Synchrotron-SOLEIL/KiCad-Lib/README.md

KiCad-Lib
=========

This repository contains the components (schematic symbols and footprints) libraries used for miscellaneous projects developped by Synchrotron SOLEIL.

There are meant to be used with KiCad EDA (http://www.kicad-pcb.org).
They were created from scratch or modified from KiCad's libraries.

Projects includes:

- TimEX3 ; multipurpose FPGA (Xilinx Spartan 6) compact PCI board ; http://www.ohwr.org/projects/timex3/wiki
- TimIQ  ; sub picosecond laser / beam delay adjust ; https://ohwr.org/project/timiq
- Macbeth ; accelerator / beamlines synchronization system ; https://ohwr.org/project/macbeth

Please refer to KiCad libraries license terms (http://kicad-pcb.org/libraries/license).

Synchrotron SOLEIL's name and logo cannot be used without permission.

----------

https://www.synchrotron-soleil.fr/en
