Synchrotron-SOLEIL/KiCad-Lib/(commit log)

2012-03-26 First commit of KiCad librairies Not yet tested !
    On branch master
    new file: Lib/footprints/CPCI.brd
    new file: Lib/footprints/CPCI_connectors.mod
    new file: Lib/footprints/HE_connectors.mod
    new file: Lib/footprints/LED.mod
    new file: Lib/footprints/OSC_SMD.mod
    new file: Lib/footprints/PSU_connectors.mod
    new file: Lib/footprints/RCL_SMT.mod
    new file: Lib/footprints/SMA_connectors.mod
    new file: Lib/footprints/SO.mod
    new file: Lib/footprints/SOT23.mod
    new file: Lib/footprints/TO263.mod
    new file: Lib/footprints/TQFP.mod
    new file: Lib/footprints/TSOT23.mod
    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
2012-03-26 Added footprint to describtion (*.dcm) of some devices
    On branch development
    modified: Lib/symbols/connectors/HE_connectors.dcm
    modified: Lib/symbols/connectors/Lemo_connectors.dcm
    modified: Lib/symbols/connectors/PSU_connectors.dcm
    modified: Lib/symbols/connectors/SMA_connectors.dcm
    modified: Lib/symbols/connectors/cpci-connectors.dcm
    modified: Lib/symbols/discrets/transistors.dcm
    modified: Lib/symbols/optoelectronics/LED.dcm
    modified: Lib/symbols/passives/filters.dcm
    modified: Lib/symbols/psu/PSU.dcm
    modified: Lib/symbols/semiconductors/ECL.dcm
    modified: Lib/symbols/semiconductors/logiques.dcm
2012-04-04 Changed some wrong text size Changed the display fields of the "VAL**" to invidible
    modified: Lib/footprints/CPCI_connectors.mod
    modified: Lib/footprints/HE_connectors.mod
    modified: Lib/footprints/LED.mod
    modified: Lib/footprints/PSU_connectors.mod
    modified: Lib/footprints/RCL_SMT.mod
    modified: Lib/footprints/SMA_connectors.mod
    modified: Lib/footprints/SO.mod
    modified: Lib/footprints/SOT23.mod
    modified: Lib/footprints/TO263.mod
    modified: Lib/footprints/TQFP.mod
    modified: Lib/footprints/lemo_connectors.mod
    modified: Lib/footprints/passives.mod
    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
2012-04-04 Corrected a pin inversion on NFM55P (pin 2 and 3)
    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
2012-04-04 Changed the size of "VAL**" field to x=y=1.27mm
    modified: Lib/footprints/OSC_SMD.mod
    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
2012-04-05 Adjusted some shapes
    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
2012-04-06 Dicovered that KiCad don't update footprint lib from PCB :( Corrected lot of mismatches between lib and PCB
    modified: Lib/footprints/TSOT23.mod
    modified: Lib/footprints/p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
2012-04-06 Corrected some silk screen shapes
    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
2012-04-16 Added fixation holes librairy. Added logo of Soleil and Open Hardware
    new file: Lib/footprints/holes.mod
    new file: Lib/footprints/logo.mod
    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
2012-04-23 Added fixation librarie Corrected bad manufacturer ref in SMA connector
    modified: Lib/symbols/connectors/SMA_connectors.lib
    new file: Lib/symbols/mecanics/holes.dcm
    new file: Lib/symbols/mecanics/holes.lib
    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
2012-05-11 Added 2 fields : type of component (useful for the capacitors) price of component
    modified: Lib/symbols/FPGA/Xilinx-Spartan3.dcm
    modified: Lib/symbols/FPGA/Xilinx-Spartan3.lib
    modified: Lib/symbols/capacitors/capacitors_aluminium.dcm
    modified: Lib/symbols/capacitors/capacitors_aluminium.lib
    modified: Lib/symbols/capacitors/capacitors_ceramic.dcm
    modified: Lib/symbols/capacitors/capacitors_ceramic.lib
    modified: Lib/symbols/capacitors/capacitors_tantalum.dcm
    modified: Lib/symbols/capacitors/capacitors_tantalum.lib
    modified: Lib/symbols/connectors/HE_connectors.lib
    modified: Lib/symbol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
2012-07-06 Added schematic symbole of PLX PCI9030-AA60PI cPCI/local bus interface
    new file: Lib/symbols/interfaces/pci.dcm
    new file: Lib/symbols/interfaces/pci.lib
    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
2012-07-09 Renamed TQFP.mod library to QFP.mod Added PQFP176 to QFP.mod
    new file: Lib/footprints/QFP.mod
    deleted: Lib/footprints/TQFP.mod
    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
2012-07-13 Added BGA.mod lib with BGA256 footprint for Xilinx FTG256 SPARTAN6 FPGA
    new file: Lib/footprints/BGA.mod
    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
2012-07-16 Renamed Xilinx-Spartan3 schematic lib to Xilinx-Spartan Added Spartan6 XC6SLX9-2FTG256C schematic symbole
    new file: Lib/symbols/FPGA/Xilinx-Spartan.dcm
    new file: Lib/symbols/FPGA/Xilinx-Spartan.lib
    deleted: Lib/symbols/FPGA/Xilinx-Spartan3.dcm
    deleted: Lib/symbols/FPGA/Xilinx-Spartan3.lib
    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
2012-07-19 Added clock buffer CY2305CSXI-1H Added some resistors
    new file: Lib/symbols/interfaces/clock.dcm
    new file: Lib/symbols/interfaces/clock.lib
    new file: Lib/symbols/resistors/resistors_0603.dcm
    new file: Lib/symbols/resistors/resistors_0603.lib
    modified: Lib/symbols/resistors/resistors_0805.dcm
    modified: Lib/symbols/resistors/resistors_0805.lib
    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
2012-07-20 Added resistor network 10Kx4 ; 22Rx4 ; 10Rx4 Added footprint for resitor network 0612
    new file: Lib/symbols/resistors/resistors_network.dcm
    new file: Lib/symbols/resistors/resistors_network.lib
    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
2012-07-23 Added Xilinx XCF04SVOG20G Renamed SOLEIL-BGA256 to SOLEIL-BGA256_1mm
    modified: Lib/footprints/BGA.mod
    new file: Lib/footprints/TSSOP.mod
    modified: Lib/symbols/FPGA/Xilinx-Spartan.lib
    new file: Lib/symbols/memories/xcf.dcm
    new file: Lib/symbols/memories/xcf.lib
    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
2012-07-24 Added xilinx JTAG platform cable connector (MOLEX 87832-1420) Modified XCF04SVOG20 for easy wire to wire connction with the JTAG connector
    modified: Lib/symbols/memories/xcf.dcm
    modified: Lib/symbols/memories/xcf.lib
    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
2012-07-31 Added header connectors TSM102-01-S-DV (2x2 2.54mm) ; TSM111-01-S-DV (2x11 2.54mm) ; TSM123-01-S-DV (2x23 2.54mm)
    modified: README.md
    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
2012-08-09 Changed the name of the clock buffer library from clock.* to clock_buffers.* Added some C0G 0603 capacitors
    renamed: Lib/symbols/interfaces/clock.dcm -> Lib/symbols/interfaces/clock_buffers.dcm
    renamed: Lib/symbols/interfaces/clock.lib -> Lib/symbols/interfaces/clock_buffers.lib
    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
2012-08-10 Corrected typo in PLX PXI9030 schematic symbol
    modified: Lib/symbols/interfaces/pci.dcm
    modified: Lib/symbols/interfaces/pci.lib
    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
2012-08-20 Added 2.2K, 0805 resistor
    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
2012-08-24 Added header connector TSM-108-02-S-DV (2x8 2.54mm)
    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
2012-08-24 Added header connector TSM-108-04-S-DV (2x4 2.54mm)
    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
2012-08-30 Corrected cPCI pin D6 from input to output
    modified: Lib/symbols/connectors/cpci-connectors.lib
    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
2012-09-06 Corrected a slightly unaligned line in the shape of the PQFP176
    modified: Lib/footprints/QFP.mod
    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
2012-09-19 Corrected a slightly unaligned line in the shape of the TSSOP20 footprint
    modified: Lib/footprints/TSSOP.mod
    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
2012-09-21 Added 0603FA1.5-R fuse (1.5A ; 32V) in fuses.lib
    new file: Lib/symbols/passives/fuses.dcm
    new file: Lib/symbols/passives/fuses.lib
    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
2012-09-24 Added MC12CF 1.5 fuse (1.5A ; 63V ; 1206)
    modified: Lib/symbols/passives/fuses.dcm
    modified: Lib/symbols/passives/fuses.lib
    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
2012-09-26 Corrected a slightly unaligned line in the shape of the TYPEB capacitor footprint Added 20021121-00010C4LF header connector ; 2x5 points ; straight ; 1.27mm pitch ; 3mm height ; SMD
    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
2012-10-08 Added a new logo of Synchrotron SOLEIL to logo library
    modified: Lib/footprints/logo.mod
    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
2012-10-12 Added open hardware logo
    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
2012-10-16 Updated manufacturer ref of part 026481046
    modified: Lib/symbols/connectors/PSU_connectors.lib
    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
2012-10-17 Corrected the footprint of NFM55P
    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
2012-10-19 Corrected drill diameter of the optical pipe
    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
2015-06-19 Changed footprints to the new KiCad format. Updated symbols with new footprints. Added some new components.
    deleted: Lib/footprints/BGA.mod
    new file: Lib/footprints/BGA.pretty/SOLEIL-BGA256_1mm.kicad_mod
    deleted: Lib/footprints/CPCI_connectors.mod
    new file: Lib/footprints/CPCI_connectors.pretty/SOLEIL-CPCI-A.kicad_mod
    deleted: Lib/footprints/HE_connectors.mod
    new file: Lib/footprints/HE_connectors.pretty/SOLEIL-87832-1420.kicad_mod
    new file: Lib/footprints/HE_connectors.pretty/SOLEIL-HE-1.27-10.kicad_mod
    new file: Lib/footprints/HE_connectors.pretty/SOLEIL-HE-13-6.kicad_mod
    new file: Lib/footprints/HE_connectors.pretty/SOLEIL-TSM-102-DV.k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
2015-06-23 Added a 2.2nF capacitor and a 10uH inductor
    new file: Lib/symbols/inductors/inductors_1210.dcm
    new file: Lib/symbols/inductors/inductors_1210.lib
    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
2015-06-23 Corrected typo error in new lib name (RLC_SMT.pretty -> RCL_SMT.pretty)
    modified: inductors/inductors_1210.lib
    modified: passives/filters.dcm
    modified: passives/filters.lib
    modified: passives/fuses.lib
    modified: passives/passives.lib
    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
2015-07-07 Added HMC1097lp4 symbol and QFN24 footprint Corrected xcf symbol
    new file: Lib/footprints/QFP.pretty/SOLEIL-QFN24.kicad_mod
    new file: Lib/symbols/RF/modulator.dcm
    new file: Lib/symbols/RF/modulator.lib
    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
2015-07-20 Added LTC2758 DAC symbol
    new file: Lib/symbols/ADC-DAC/DAC.dcm
    new file: Lib/symbols/ADC-DAC/DAC.lib
    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
2015-07-21 Added LQFP48 ffotprint
    new file: Lib/footprints/QFP.pretty/SOLEIL-LQFP48.kicad_mod
    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
2015-07-22 Added voltages regulators
    modified: Lib/symbols/voltages/reference.dcm
    modified: Lib/symbols/voltages/reference.lib
    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
2015-07-23 Added MSOP8 footprint and some resistor
    new file: Lib/footprints/MSOP.pretty/SOLEIL-MSOP8.kicad_mod
    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
2015-07-27 Added some capacitors ; +15V and -15V symbols ; etc.
    modified: Lib/symbols/RF/modulator.lib
    modified: Lib/symbols/analogs/opa.lib
    modified: Lib/symbols/power.dcm
    modified: Lib/symbols/power.lib
    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
2015-07-27 Added 10uF ceramic capacitor
    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
2015-07-28 Added some resistore ; added LT1360CS8 OPA
    modified: Lib/symbols/analogs/opa.dcm
    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
2015-07-29 Added QWFN footprint
    new file: Lib/footprints/QFP.pretty/SOLEIL-WQFN36.kicad_mod
    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
2015-07-31 Added some 0603 resistors
    modified: Lib/symbols/resistors/resistors_0603.dcm
    modified: Lib/symbols/resistors/resistors_0603.lib
    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
2015-07-31 Corrected some typo error
    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
2015-08-03 Added some resistors and capacitors
    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
2015-08-04 Added some resistors, capacitors, a VCXO and a ferrite
    new file: Lib/footprints/OSC_SMD.pretty/SOLEIL-SMD9x14.kicad_mod
    modified: Lib/symbols/oscillators/oscillators.dcm
    modified: Lib/symbols/oscillators/oscillators.lib
    modified: Lib/symbols/passives/filters.lib
    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
2015-08-05 Typo correction
    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
2015-08-06 Added DQ1225 footprint
    new file: Lib/footprints/QFP.pretty/SOLEIL-DQ1225.kicad_mod
    modified: Lib/footprints/QFP.pretty/SOLEIL-WQFN36.kicad_mod
    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
2015-08-18 Added QCN-34+ RF splitter symbole and footprint
    new file: Lib/footprints/RCL_SMT.pretty/SOLEIL-FV1206-1.kicad_mod
    modified: Lib/symbols/RF/splitter.dcm
    modified: Lib/symbols/RF/splitter.lib
    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
2015-08-20 Corrected minor errors
    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
2015-08-21 Added SIM-73L+ RF mixer symbol and footprint
    new file: Lib/footprints/SO.pretty/SOLEIL-HV1195.kicad_mod
    new file: Lib/symbols/RF/mixer.dcm
    new file: Lib/symbols/RF/mixer.lib
    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
2015-08-24 Added a few resistors, capacitors and inductors
    new file: Lib/symbols/inductors/inductors_0603.dcm
    new file: Lib/symbols/inductors/inductors_0603.lib
    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
2015-09-15 Added GAT-5+ attenuator
    new file: Lib/footprints/passives.pretty/SOLEIL-FG873.kicad_mod
    new file: Lib/symbols/RF/attenuator.dcm
    new file: Lib/symbols/RF/attenuator.lib
    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
2015-09-18 Modified the name of RCL_SMT directory to RCL_SMD Added some resistors
    renamed: Lib/footprints/RCL_SMT.pretty/SOLEIL-0603.kicad_mod -> Lib/footprints/RCL_SMD.pretty/SOLEIL-0603.kicad_mod
    renamed: Lib/footprints/RCL_SMT.pretty/SOLEIL-0612.kicad_mod -> Lib/footprints/RCL_SMD.pretty/SOLEIL-0612.kicad_mod
    renamed: Lib/footprints/RCL_SMT.pretty/SOLEIL-0805.kicad_mod -> Lib/footprints/RCL_SMD.pretty/SOLEIL-0805.kicad_mod
    renamed: Lib/footprints/RCL_SMT.pretty/SOLEIL-1206.kicad_mod -> Lib/footprints/RCL_SMD.pretty/SOLEIL-1206.kicad_mod
    renamed: Lib/footprints/RCL_SMT.pretty/SOLEIL-1210.kicad_mod -> Lib/footprints/RCL_SMD.pretty/SOLEIL-1210.kicad_mod
    rena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
2015-09-18 Added 3d modelee to some resistors for tests purpose
    modified: Lib/footprints/RCL_SMD.pretty/SOLEIL-0603.kicad_mod
    modified: Lib/footprints/RCL_SMD.pretty/SOLEIL-0805.kicad_mod
    modified: Lib/footprints/RCL_SMD.pretty/SOLEIL-1206.kicad_mod
    modified: Lib/footprints/RCL_SMD.pretty/SOLEIL-2512.kicad_mod
    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
2015-09-28 Added some 0603 resitors
    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
2015-10-09 Added OPA2209AIDGKR OPA Added some 0603 resistors Added some 0603 capacitors
    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
2015-10-12 Swapped pin 2 and 3 in the OPA2209AIDGKR symbol
    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
2015-10-12 Added ADS8694IDBT ADC
    renamed: Lib/footprints/TSSOP.pretty/SOLEIL-TSSOP20.kicad_mod -> Lib/footprints/TSSOP.pretty/SOLEIL-TSSOP20-0.65.kicad_mod
    new file: Lib/footprints/TSSOP.pretty/SOLEIL-TSSOP38-0.5.kicad_mod
    new file: Lib/symbols/ADC-DAC/ADC.dcm
    new file: Lib/symbols/ADC-DAC/ADC.lib
    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
2015-10-13 Added 1.25V and 4.096V voltage reference
    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
2015-10-14 Chaged symbole shape ; added capacitors ; corrected typo in resistor lib
    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
2015-10-16 Added VQFN20 and WQFN24 footprint
    new file: Lib/footprints/QFP.pretty/SOLEIL-VQFN20.kicad_mod
    new file: Lib/footprints/QFP.pretty/SOLEIL-WQFN24.kicad_mod
    modified: Lib/symbols/psu/PSU.lib
    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
2015-10-19 Added TPS7A4700 LDO schematic symbol
    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
2015-10-19 Splitted ceramic capacitors symbols according to their package
    renamed: Lib/symbols/capacitors/capacitors_ceramic.dcm -> Lib/symbols/capacitors/capacitors_ceramic_0603.dcm
    renamed: Lib/symbols/capacitors/capacitors_ceramic.lib -> Lib/symbols/capacitors/capacitors_ceramic_0603.lib
    new file: Lib/symbols/capacitors/capacitors_ceramic_0805.dcm
    new file: Lib/symbols/capacitors/capacitors_ceramic_0805.lib
    new file: Lib/symbols/capacitors/capacitors_ceramic_1206.dcm
    new file: Lib/symbols/capacitors/capacitors_ceramic_1206.lib
    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
2015-10-19 Changed a pin name
    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
2015-12-14 Added 10 pF 0603 capacitor Corrected typo in LTC name
    modified: Lib/symbols/capacitors/capacitors_ceramic_0603.dcm
    modified: Lib/symbols/capacitors/capacitors_ceramic_0603.lib
    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
2016-02-01 Added SMA End Launch Jack for 0.047 inch PCB, 50 Ohm, Flat Tab Contact
    new file: Lib/footprints/SMA_connectors.pretty/SOLEIL-SMA-132430.kicad_mod
    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
2016-02-01 Added LP3966ES-3.3 3.3V LDO
    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
2016-02-02 Added SAMTEC QSH-040-01-F-D-DP-A footprint
    new file: Lib/footprints/HE_connectors.pretty/SOLEIL-QSH-040-01-F-D-DP-A.kicad_mod
    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
2016-02-03 Added QSH-040-01-F-D-DP-A symbol ; updated footprint
    modified: Lib/footprints/HE_connectors.pretty/SOLEIL-QSH-040-01-F-D-DP-A.kicad_mod
    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
2016-02-03 Add Spartan FPGA XC6SLX16-2FTG256C ; SN74LV4T125
    new file: Lib/footprints/TSSOP.pretty/SOLEIL-TSSOP14-0.65.kicad_mod
    modified: Lib/symbols/FPGA/Xilinx-Spartan.dcm
    modified: Lib/symbols/semiconductors/logic.dcm
    modified: Lib/symbols/semiconductors/logic.lib
    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
2016-02-08 Added EMI shield
    new file: Lib/footprints/passives.pretty/SOLEIL-BMI-S-204-F.kicad_mod
    new file: Lib/symbols/mecanics/RF_shields.dcm
    new file: Lib/symbols/mecanics/RF_shields.lib
    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
2016-02-08 Added QSPI EEPROM W25Q64FVSSIG
    modified: Lib/footprints/SO.pretty/SOLEIL-SOIC8NB.kicad_mod
    modified: Lib/symbols/memories/EEPROM.dcm
    modified: Lib/symbols/memories/EEPROM.lib
    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
2016-02-10 Added BeagleBone Black header
    new file: Lib/footprints/HE_connectors.pretty/SOLEIL-BeagleBoneBlack-P8.kicad_mod
    new file: Lib/footprints/HE_connectors.pretty/SOLEIL-BeagleBoneBlack-P9.kicad_mod
    new file: Lib/footprints/HE_connectors.pretty/SOLEIL-TSW-123-14-G-D.kicad_mod
    new file: Lib/symbols/microprocessors/BeagleBoneBlack_header.dcm
    new file: Lib/symbols/microprocessors/BeagleBoneBlack_header.lib
    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
2016-02-12 Added 2x13 2.54mm header footprint
    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
2016-02-18 Added 2 5V and 3V3 voltage symbols
    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
2016-02-19 Modification of SAMTEC diff connector
    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
2016-02-19 Added 10uF 16V 0805 X5R capacitor
    modified: Lib/symbols/capacitors/capacitors_ceramic_0805.dcm
    modified: Lib/symbols/capacitors/capacitors_ceramic_0805.lib
    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
2016-02-22 Added NFM41P filter
    new file: Lib/footprints/RCL_SMD.pretty/SOLEIL-NFM41P.kicad_mod
    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
2016-02-22 Added Molex Mini-fit 6 point connector
    new file: Lib/footprints/PSU_connectors.pretty/SOLEIL-39-30-1061.kicad_mod
    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
2016-02-24 Added some resistors
    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
2016-02-24 Corrected output type pin to input type
    modified: Lib/symbols/ADC-DAC/DAC.lib
    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
2016-02-25 Corrected ADS8694 missing pins
    modified: Lib/symbols/ADC-DAC/ADC.lib
    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
2016-02-29 Changed no connect pins of HMC705LP4E to power input as they are grounded in the demo board
    modified: Lib/symbols/RF/freq_div.lib
    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
2016-03-02 Corrected errors in 15V, -15V power symbols
    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
2016-03-04 Added Mini-Circuits MC1631 footprint
    new file: Lib/footprints/SO.pretty/SOLEIL-MC1631.kicad_mod
    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
2016-03-04 Corrected typo errors
    modified: Lib/symbols/inductors/inductors_0603.dcm
    modified: Lib/symbols/inductors/inductors_1210.dcm
    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
2016-03-04 Corrected some errors in symbols / footprints links
    modified: Lib/footprints/QFP.pretty/SOLEIL-WQFN24.kicad_mod
    modified: Lib/symbols/RF/mixer.lib
    modified: Lib/symbols/passives/passives.lib
    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
2016-04-28 Added and corrected footprints
    modified: Lib/footprints/BGA.pretty/SOLEIL-BGA256_1mm.kicad_mod
    modified: Lib/footprints/TSSOP.pretty/SOLEIL-TSSOP14-0.65.kicad_mod
    new file: Lib/footprints/passives.pretty/SOLEIL-1590Q.kicad_mod
    modified: Lib/symbols/mecanics/RF_shields.dcm
    modified: Lib/symbols/mecanics/RF_shields.lib
    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
2016-04-29 Added MAX IV logo Modified BOX pins footprint
    new file: Lib/footprints/logo.pretty/logo_maxvi_400.kicad_mod
    modified: Lib/footprints/passives.pretty/SOLEIL-1590Q.kicad_mod
    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
2016-05-06 Corrected missing Mask and Paste zone on bottom pins
    modified: Lib/footprints/SMA_connectors.pretty/SOLEIL-SMA-132430.kicad_mod
    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
2016-05-11 Corrected some supplier ref.
    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
2016-06-01 Added RS485 components
    new file: Lib/footprints/PSU_connectors.pretty/SOLEIL-1725669.kicad_mod
    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
2016-06-01 Changed text size to 1 mm and thickness to 0.15 mm
    modified: Lib/footprints/CPCI_connectors.pretty/SOLEIL-CPCI-A.kicad_mod
    modified: Lib/footprints/HE_connectors.pretty/SOLEIL-87832-1420.kicad_mod
    modified: Lib/footprints/HE_connectors.pretty/SOLEIL-BeagleBoneBlack-P8.kicad_mod
    modified: Lib/footprints/HE_connectors.pretty/SOLEIL-BeagleBoneBlack-P9.kicad_mod
    modified: Lib/footprints/HE_connectors.pretty/SOLEIL-HE-1.27-10.kicad_mod
    modified: Lib/footprints/HE_connectors.pretty/SOLEIL-HE-13-6.kicad_mod
    modified: Lib/footprints/HE_connectors.pretty/SOLEIL-QSH-040-01-F-D-DP-A.kicad_mod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
2016-06-02 Added 68 µF tantalum capacitor
    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
2016-06-03 Added SI500 100MHz LVEPCL 3V3 oscillator symbol and footprint
    new file: Lib/footprints/OSC_SMD.pretty/SOLEIL-SMD5x7.kicad_mod
    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
2016-06-03 Added 130R and 82R 0603 resitors
    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
2016-06-07 Added Ethernet PHY LAN8810
    new file: Lib/footprints/QFP.pretty/SOLEIL-WQFN72.kicad_mod
    new file: Lib/symbols/interfaces/ethernet.dcm
    new file: Lib/symbols/interfaces/ethernet.lib
    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
2016-06-08 Added RJ45 connector
    new file: Lib/footprints/RJ45_connectors.pretty/SOLEIL-RJ45-HFJ11-1G01E-L12RL.kicad_mod
    new file: Lib/symbols/connectors/RJ45_connectors.dcm
    new file: Lib/symbols/connectors/RJ45_connectors.lib
    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
2016-06-08 Added 25 MHz crystal
    new file: Lib/footprints/OSC_SMD.pretty/SOLEIL-HC49S.kicad_mod
    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
2016-06-08 Added 2.5V 3A LDO
    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
2016-06-09 Added 8K06 resistor
    modified: Lib/symbols/interfaces/ethernet.lib
    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
2016-06-21 Corrected inversion in P8/P9 BBB connectors
    renamed: Lib/footprints/HE_connectors.pretty/SOLEIL-BeagleBoneBlack-P9.kicad_mod -> Lib/footprints/HE_connectors.pretty/SOLEIL-BeagleBoneBlack-P8.kicad_mod
    renamed: Lib/footprints/HE_connectors.pretty/SOLEIL-BeagleBoneBlack-P8.kicad_mod -> Lib/footprints/HE_connectors.pretty/SOLEIL-BeagleBoneBlack-P9.kicad_mod
    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
2016-06-22 Added 25MHz crystal in 5x3.2mm case SMD
    new file: Lib/footprints/OSC_SMD.pretty/SOLEIL-SMD5x3_2.kicad_mod
    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
2016-07-01 Corrected some pin spaces due to KiCad version conversion
    modified: Lib/footprints/TSOT23.pretty/SOLEIL-TSOT23-8.kicad_mod
    modified: Lib/footprints/TSSOP.pretty/SOLEIL-TSSOP20-0.65.kicad_mod
    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
2016-07-08 Removed mask clerance from BGA 256 footprint
    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
2016-09-20 Added 3.1 mm and 3.0 mm holes
    modified: Lib/footprints/holes.pretty/SOLEIL-D_2mm8.kicad_mod
    new file: Lib/footprints/holes.pretty/SOLEIL-D_3mm0.kicad_mod
    new file: Lib/footprints/holes.pretty/SOLEIL-D_3mm1.kicad_mod
    modified: Lib/symbols/mecanics/holes.dcm
    modified: Lib/symbols/mecanics/holes.lib
    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
2017-04-27 Added some 0603 resistors and capacitors
    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
2018-07-24 Added some 3d shapes Corrected uppercase / lowercase error for KiCad V5
    On branch KiCad_V5
    modified: Lib/footprints/RCL_SMD.pretty/SOLEIL-1210.kicad_mod
    modified: Lib/footprints/RCL_S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
2018-07-25 Adding 3d models
    modified: Lib/footprints/LED.pretty/SOLEIL-KP-3216.kicad_mod
    modified: Lib/footprints/LED.pretty/SOLEIL-M67K.kicad_mod
    modified: Lib/footprints/MSOP.pretty/SOLEIL-MSOP8.kicad_mod
    modified: Lib/footprints/OSC_SMD.pretty/SOLEIL-FXO-HC73.kicad_mod
    modified: Lib/footprints/RCL_SMD.pretty/SOLEIL-0612.kicad_mod
    modified: Lib/footprints/RCL_SMD.pretty/SOLEIL-PC-A.kicad_mod
    modified: Lib/footprints/RCL_SMD.pretty/SOLEIL-PC-B.kicad_mod
    modified: Lib/footprints/RCL_SMD.pretty/SOLEIL-TYPEB.kicad_mod
    modified: Lib/footprints/RCL_SMD.pretty/SOLEIL-TYPEE.kicad_mod
    new file: Lib/packages3d_extra/LED_SMD.3dshapes/Osram_M67K_L2.3mm_W1.3mm_H1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
2018-07-26 Added some 3D shapes:
    new file: Lib/packages3d_extra/Connector_Samtec.3dshapes/Samtec_QSH_040_01_F_D_DP_A.step
    new file: Lib/packages3d_extra/Connector_Samtec.3dshapes/Samtec_QSH_040_01_F_D_DP_A.wrl
    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
2018-07-27 Reorganised 3D folders ; added some models
    modified: Lib/footprints/RJ45_connectors.pretty/SOLEIL-RJ45-HFJ11-1G01E-L12RL.kicad_mod
    modi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
2018-07-27 Modified README.md
    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
2018-07-27 added 3D models
    modified: Lib/footprints/OSC_SMD.pretty/SOLEIL-SMD5x7.kicad_mod
    modified: Lib/footprints/PSU_connectors.pretty/SOLEIL-1725669.kicad_mod
    modified: Lib/footprints/PSU_connectors.pretty/SOLEIL-39-30-1061.kicad_mod
    modified: Lib/footprints/QFP.pretty/SOLEIL-LQFP48.kicad_mod
    modified: Lib/footprints/QFP.pretty/SOLEIL-PQFP176.kicad_mod
    modified: Lib/footprints/QFP.pretty/SOLEIL-QFN24.kicad_mod
    modified: Lib/footprints/QFP.pretty/SOLEIL-TQFP144.kicad_mod
    modified: Lib/footprints/QFP.pretty/SOLEIL-VQFN20.kicad_mod
    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
2018-07-30 dded 3D models
    modified: Lib/footprints/QFP.pretty/SOLEIL-DQ1225.kicad_mod
    modified: Lib/footprints/SMA_connectors.pretty/SOLEIL-SMA-132134.kicad_mod
    new file: Lib/packages3d/Connector_Coaxial.3dshapes/SMA_Molex_733910071_Jack_Vertical.step
    new file: Lib/packages3d/Connector_Coaxial.3dshapes/SMA_Molex_733910071_Jack_Vertical.wrl
    new file: Lib/packages3d/Connector_PinHeader_1.27mm.3dshapes/PinHeader_2x05_P1.27mm_Vertical_SMD.step
    new file: Lib/packages3d/Connector_PinHeader_1.27mm.3dshapes/PinHeader_2x05_P1.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
2018-08-03 Corrected 3D models
    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
2018-08-06 Added compact PCI type A 3D model
    new file: Lib/packages3d/Connector_Erni.3dshapes/Erni_064176_cPCI_TypeA.step
    new file: Lib/packages3d/Connector_Erni.3dshapes/Erni_064176_cPCI_TypeA.wrl
    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
2018-08-06 Added 3D models
    modified: Lib/footprints/HE_connectors.pretty/SOLEIL-TSM-102-DV.kicad_mod
    modified: Lib/footprints/HE_connectors.pretty/SOLEIL-TSM-104-DV.kicad_mod
    modified: Lib/footprints/HE_connectors.pretty/SOLEIL-TSM-108-DV.kicad_mod
    modified: Lib/footprints/HE_connectors.pretty/SOLEIL-TSM-111-DV.kicad_mod
    modified: Lib/footprints/HE_connectors.pretty/SOLEIL-TSM-123-DV.kicad_mod
    modified: Lib/footprints/HE_connectors.pretty/SOLEIL-TSW-123-14-G-D.kicad_mod
    new file: Lib/packages3d/Connector_Samtec.3dshapes/Samtec_TSM_102_02_S_DV_2x2_P2.54mm_Vetical.step
    new file: Lib/packages3d/Connector_Samtec.3dshapes/Samtec_TSM_102_02_S_DV_2x2_P2.54mm_Vetical.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
2018-08-10 Added 3 D shapes
    new file: Lib/packages3d/Package_QFP.3dshapes/QFN-12-1EP_3x3mm_Pitch0.5mm.step
    new file: Lib/packages3d/Package_QFP.3dshapes/QFN-12-1EP_3x3mm_Pitch0.5mm.wrl
    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
2018-08-10 Added Mini-circuit 3D shape FG873
    modified: Lib/footprints/passives.pretty/SOLEIL-FG873.kicad_mod
    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
2018-08-21 Added 3D Model for Mini-Circuit GAT-5+ attenuator (FG873 package)
    new file: Lib/packages3d/Package_DFN_QFN.3dshapes/Mini-Circuits_FG873-4_3x3mm.step
    new file: Lib/packages3d/Package_DFN_QFN.3dshapes/Mini-Circuits_FG873-4_3x3mm.wrl
    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
2021-02-15 Update the lib for Kicad v6
    Updating the library for the v6 of Kicad.
    So far:
    * resitors
    * resistor networks
    * ADC
    * DAC
    On branch kicad_v6
    deleted: Lib/symbols/ADC-DAC/ADC.dcm
    new file: Lib/symbols/ADC-DAC/ADC.kicad_sym
    deleted: Lib/symbols/ADC-DAC/ADC.lib
    deleted: Lib/symbols/ADC-DAC/DAC.dcm
    new file: Lib/symbols/ADC-DAC/DAC.kicad_sym
    deleted: Lib/symbols/ADC-DAC/DAC.lib
    deleted: Lib/symbols/resistors/resistors_0603.dcm
    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
2021-02-16 Upgrade library to Kicad v6
    Upgraded the libray for Kicad v6:
    * Ceramic capacitors
    * Aluminim capacitors
    * Tantalum capacitors
    deleted: Lib/symbols/capacitors/capacitors_aluminium.dcm
    new file: Lib/symbols/capacitors/capacitors_aluminium.kicad_sym
    deleted: Lib/symbols/capacitors/capacitors_aluminium.lib
    deleted: Lib/symbols/capacitors/capacitors_ceramic_0603.dcm
    new file: Lib/symbols/capacitors/capacitors_ceramic_0603.kicad_sym
    deleted: Lib/symbols/capacitors/capacitors_ceramic_0603.lib
    deleted: Lib/symbols/capacitors/capacitors_ceramic_0805.dcm
    new file: Lib/symbols/capacitors/capacitors_ceramic_0805.kicad_sym
    deleted: Lib/symbols/capa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
2021-02-16 Upgrading library for Kicad v6
    Changed the folders names to match Kicad name
    Upgraded library:
    * Analog AOP
    * Transistors
    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
2021-02-16 Upgrade to Kicad v6
    Upgrade of library to Kicad v6:
    * cPCI connector
    * Mini-circuit AOP
    * Inductors
    new file: library/connectors/CPCI_connectors.kicad_sym
    deleted: library/inductors/inductors_0603.dcm
    new file: library/inductors/inductors_0603.kicad_sym
    deleted: library/inductors/inductors_0603.lib
    deleted: library/inductors/inductors_1210.dcm
    deleted: library/inductors/inductors_1210.lib
    deleted: modules/CPCI_connectors.pretty/SOLEIL-CPCI-A.kicad_mod
    new file: modules/Connector_Erni.pretty/Erni_ERmet_Female_Type_A-354142.kicad_mod
    modified: modules/RF_Mini-Circuits.pretty/Mini-Circuits_MC1631.kicad_mod
    renamed: packages3d/Connector_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
2021-02-17 Added Block transformer
    Added Block VB 1,0/1/6 transformer to the library
    Modified absolute links to relative links
    deleted: Lib/library/connectors/CPCI_connectors.dcm
    deleted: Lib/library/connectors/CPCI_connectors.lib
    new file: Lib/library/psu/Transformer.kicad_sym
    modified: Lib/modules/Connector_Erni.pretty/Erni_ERmet_Female_Type_A-354142.kicad_mod
    new file: Lib/modules/Transformer.pretty/Block_VB_1_0_1_6-28x33.kicad_mod
    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
2021-02-18 Upgrading to Kicad v6 and adding some components
    Added 820R (1% and 0.1%)
    Added LTC6702 comparator
    Added LTC6752 comparator (copy from Kicad lib)
    Added MB6S diode bridge (copy from Kicad lib)
    renamed: Lib/library/analogs/opa.kicad_sym -> Lib/library/analogs/Amplifier.kicad_sym
    new file: Lib/library/analogs/Comparator.kicad_sym
    new file: Lib/library/discretes/diode_bridge.kicad_sym
    modified: Lib/library/resistors/resistors_0603.kicad_sym
    modified: Lib/library/resistors/resistors_0805.kicad_sym
    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
2021-02-19 Upgrade to Kicad v6
    Upgraded the voltage reference
    Added LTC6655-3.3 voltage reference
    deleted: Lib/library/voltages/reference.dcm
    new file: Lib/library/voltages/reference.kicad_sym
    deleted: Lib/library/voltages/reference.lib
    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
2021-02-19 Upgrade of library to Kicad v6
    Upgraded:
    * PSU LDO
    * Voltage monitor
    new file: Lib/library/psu/LDO.kicad_sym
    deleted: Lib/library/psu/PSU.dcm
    deleted: Lib/library/psu/PSU.lib
    new file: Lib/library/voltages/Voltage_monitor.kicad_sym
    renamed: Lib/library/voltages/reference.kicad_sym -> Lib/library/voltages/Voltage_reference.kicad_sym
    renamed: Lib/packages3d/Package_DFN_QFN.3dshapes/VQFN-20_5x5mm_P0.65mm.step -> Lib/packages3d/Package_DFN_QFN.3dshapes/Texas_S-PVQFN-N20_EP3.15x3.15mm.step
    renamed: Lib/packages3d/Package_DFN_QFN.3dshapes/VQFN-20_5x5mm_P0.65mm.wrl -> Lib/packages3d/Package_DFN_QFN.3dshapes/Texas_S-PVQFN-N20_EP3.15x3.15mm.wrl
    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
2021-02-19 Removed visible datasheet links
    Removed some visible datasheet links in components property to avoid
    show them in shematocs
    modified: Lib/library/psu/LDO.kicad_sym
    modified: Lib/library/voltages/Voltage_monitor.kicad_sym
    modified: Lib/library/voltages/Voltage_reference.kicad_sym
    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
2021-02-22 Added Phonix Contact MKDS 1x2 terminal connector
    new file: Lib/library/connectors/Terminal_connectors.kicad_sym
    new file: Lib/modules/Connector_Phoenix.pretty/Phoenix_MKDS_1x02_P5mm_Vertical.kicad_mod
    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
2021-02-23 Updating library to Kicad v6
    Updated the PinHeader Connectors HE to Kicad v6
    deleted: Lib/library/connectors/HE_connectors.dcm
    new file: Lib/library/connectors/HE_connectors.kicad_sym
    deleted: Lib/library/connectors/HE_connectors.lib
    modified: Lib/modules/HE_connectors.pretty/SOLEIL-87832-1420.kicad_mod
    modified: Lib/modules/HE_connectors.pretty/SOLEIL-BeagleBoneBlack-P8.kicad_mod
    modified: Lib/modules/HE_connectors.pretty/SOLEIL-BeagleBoneBlack-P9.kicad_mod
    modified: Lib/modules/HE_connectors.pretty/SOLEIL-HE-1.27-10.kicad_mod
    modified: Lib/modules/HE_connectors.pretty/SOLEIL-HE-13-6.kicad_mod
    modified: Lib/modules/HE_connectors.pretty/SOLE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
2021-02-25 Added Cora Z7 footprint
    Added the Digilent's Zynq SBC Cora Z7 footprint
    renamed: Lib/library/microprocessors/BeagleBoneBlack_header.dcm -> Lib/library/SBC/BeagleBoneBlack_header.dcm
    renamed: Lib/library/microprocessors/BeagleBoneBlack_header.lib -> Lib/library/SBC/BeagleBoneBlack_header.lib
    new file: Lib/modules/SBC.pretty/Cora_Z7.kicad_mod
    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
2021-02-25 Added Cora Z7 schematic symbol
    Added the Cora Z7 symbol to the library
    new file: Lib/library/SBC/SBC.kicad_sym
    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
2021-02-26 Updated the logic lib to Kicad v6
    Updated the logic library to Kicad v6
    Corrected en error in SBC shematic library
    modified: Lib/library/SBC/SBC.kicad_sym
    deleted: Lib/library/semiconductors/logic.dcm
    new file: Lib/library/semiconductors/logic.kicad_sym
    deleted: Lib/library/semiconductors/logic.lib
    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
2021-02-26 Added a SMA connector to the library
    new file: Lib/library/connectors/SMA_connectors.kicad_sym
    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
2021-03-01 Added some capacitors and resitors
    modified: Lib/library/capacitors/capacitors_ceramic_0805.kicad_sym
    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
2021-03-01 Updating library to Kicad v6
    Updated filters, LEDs and test point library.
    Removed some components from those library
    deleted: Lib/library/optoelectronics/LED.dcm
    new file: Lib/library/optoelectronics/LED.kicad_sym
    deleted: Lib/library/optoelectronics/LED.lib
    deleted: Lib/library/passives/filters.dcm
    new file: Lib/library/passives/filters.kicad_sym
    deleted: Lib/library/passives/filters.lib
    new file: Lib/library/passives/passives.kicad_sym
    new file: Lib/modules/Filter.pretty/Filter_Murata-NFM41P.kicad_mod
    deleted: Lib/modules/RCL_SMD.pretty/SOLEIL-NFM41P.kicad_mod
    deleted: Lib/modules/passives.pretty/SOLEIL-1590Q.kicad_mod
    deleted: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
2021-03-02 Added Bivar SMFLP Series Flexible LED Light Pipes symbole and footprint
    new file: Lib/library/optoelectronics/OpticalDevice.kicad_sym
    new file: Lib/modules/OptoDevice.pretty/Bivar_SMFLP.kicad_mod
    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
2021-03-03 Added a SMD bicolor LED
    modified: Lib/library/optoelectronics/LED.kicad_sym
    new file: Lib/modules/LED.pretty/LED_RGB_Wurth-PLCC4_3.2x2.8mm_150141SV73110.kicad_mod
    deleted: Lib/modules/LED.pretty/SOLEIL-KP-3216.kicad_mod
    deleted: Lib/modules/LED.pretty/SOLEIL-M67K.kicad_mod
    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
2021-03-04 Updated MOSFET transistor
    Updated MOSFET transitor BSN20 to BSN20BK as it is now NRND
    modified: Lib/library/discretes/transistors.kicad_sym
    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
2021-03-04 Cleaned mechanical hole library
    The mechanical hole library has been updated to Kicad v6.
    Replaced holes with Kicad's modules.
    deleted: Lib/library/mecanics/holes.dcm
    deleted: Lib/library/mecanics/holes.lib
    renamed: Lib/library/mecanics/RF_shields.dcm -> Lib/library/mechanicals/RF_shields.dcm
    renamed: Lib/library/mecanics/RF_shields.lib -> Lib/library/mechanicals/RF_shields.lib
    new file: Lib/library/mechanicals/holes.kicad_sym
    deleted: Lib/modules/holes.pretty/SOLEIL-D_2mm8.kicad_mod
    deleted: Lib/modules/holes.pretty/SOLEIL-D_3mm0.kicad_mod
    deleted: Lib/modules/holes.pretty/SOLEIL-D_3mm1.kicad_mod
    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
2021-03-05 Added Hammond's 1590QY footprint
    new file: Lib/modules/passives.pretty/ Hammond_1590QY.kicad_mod
    new file: Lib/modules/passives.pretty/S_1590QY.kicad_mod
    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
2021-03-05 Added Hammound's 1590Y box symbol and 3D
    new file: Lib/library/mechanicals/box.kicad_sym
    new file: Lib/modules/Boxes.pretty/Hammond_1590QY.kicad_mod
    deleted: Lib/modules/passives.pretty/ Hammond_1590QY.kicad_mod
    deleted: Lib/modules/passives.pretty/S_1590QY.kicad_mod
    new file: Lib/packages3d/Boxes/Hammond_Manufacturing_1590Y_92x92x42mm.step
    new file: Lib/packages3d/Boxes/Hammond_Manufacturing_1590Y_92x92x42mm.wrl
    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
2021-03-09 Dealing with Kicad bug
    It seems that Kicad has some problem with footprint assignement and it
    need to be re-assigned severeal time in the symbole library.
    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
2021-03-09 Added Bud box
    modified: Lib/library/mechanicals/box.kicad_sym
    new file: Lib/modules/Boxes.pretty/Bud_Industries_CN-5700.kicad_mod
2021-03-15 Updated Cora Z7 footprint
    Added on Fab layer the connector number (C_Jx) and contours.
    modified: Lib/modules/SBC.pretty/Cora_Z7.kicad_mod
    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
2021-03-29 Modified Cora Z7 footprint + voltage warning symbol
    * Added a Cora Z7 bottom viem footprint
    * Refreshed Cora Z7 top view footprint
    * Added voltage warning symbole on silkscreen as PCB footprint
    new file: Lib/modules/SBC.pretty/Cora-Z7_bottom.kicad_mod
    new file: Lib/modules/SBC.pretty/Cora-Z7_top.kicad_mod
    deleted: Lib/modules/SBC.pretty/Cora_Z7.kicad_mod
    new file: Lib/modules/Symbol.pretty/electricity_10x10mm.kicad_mod
    new file: Lib/modules/Symbol.pretty/electricity_34x34mm.kicad_mod
    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
2021-04-20 Corrected an error in LTC6655BHMS8-33 ref
    Corrected the LTC6655BHMS8-33 manufacturer field error (1.25 to 3.3)
    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
2021-09-06 Update of the libraries
    Updated the libraries to improve silkscreens.
    Added 3D model to SMA connector.
    modified: Lib/library/analogs/Comparator.kicad_sym
    modified: Lib/library/capacitors/capacitors_tantalum.kicad_sym
    modified: Lib/library/connectors/SMA_connectors.kicad_sym
    modified: Lib/library/discretes/diode_bridge.kicad_sym
    modified: Lib/library/semiconductors/logic.kicad_sym
    new file: Lib/modules/Connector_coaxial.pretty/SMA_Amphenol_132203-12_Horizontal.kicad_mod
    new file: Lib/modules/Diode.pretty/TO-269AA.kicad_mod
    new file: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
2022-01-04 Changed MB6S symbol
    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
2022-01-14 Changed footprints and symbols folders names to KiCad v6.0's names
    As KiCad has changed folders names:
    * modules changed to footprints
    * librairies changed to symbols
2022-01-14 Updated some footprints and symboles to KiCad v6.0
2022-01-21 Changed lib to KiCad v6.0
    renamed: Lib/footprints/Diode.pretty/TO-269AA.kicad_mod -> Lib/footprints/Diode_SMD.pretty/TO-269AA.kicad_mod
    renamed: Lib/footprints/LED.pretty/LED_0805_2012Metric.kicad_mod -> Lib/footprints/LED_SMD.pretty/LED_0805_2012Metric.kicad_mod
    new file: Lib/footprints/LED_SMD.pretty/LED_1206_3216Metric.kicad_mod
    renamed: Lib/footprints/LED.pretty/LED_RGB_Wurth-PLCC4_3.2x2.8mm_150141SV73110.kicad_mod -> Lib/footprints/LED_SMD.pretty/LED_RGB_Wurth-PLCC4_3.2x2.8mm_150141SV73110.kicad_mod
    deleted: Lib/footprints/MSOP.pretty/SOLEIL-MSOP8.kicad_mod
    modified: Lib/symbols/discretes/diode_bridge.kicad_sym
    modified: Lib/symbols/discretes/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
2022-01-25 Corrected EEEFC1A101P voltage from 16V to 10V
    modified: Lib/symbols/capacitors/capacitors_aluminium.kicad_sym
    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
2022-02-28 Corrected Bivar SMFLP hole diameter
    Reduced the diameter of the Bivar_SMFLP mechanical hole from 2.64 mm to
    2.56 mm.
    Removed old Kicad v4 footprints
    modified: Lib/footprints/OptoDevice.pretty/Bivar_SMFLP.kicad_mod
    deleted: Lib/footprints/RCL_SMD.pretty/SOLEIL-0612.kicad_mod
    deleted: Lib/footprints/RCL_SMD.pretty/SOLEIL-0805.kicad_mod
    deleted: Lib/footprints/RCL_SMD.pretty/SOLEIL-1210.kicad_mod
    deleted: Lib/footprints/RCL_SMD.pretty/SOLEIL-2512.kicad_mod
    deleted: Lib/footprints/RCL_SMD.pretty/SOLEIL-TYPEB.kicad_mod
    deleted: Lib/footprints/RCL_SMD.pretty/SOLEIL-TYPEE.kicad_mod
    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
2022-08-01 Added TimXXX and IQ modulator boards
    Added the TimXXX family of boards and the IQ modulator board for interconnexion schematics (not electronics components!).
    new file: Lib/symbols/boards/TimXXX.kicad_sym
    new file: Lib/symbols/boards/misc_boards.kicad_sym
    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
2022-08-03 Added and corrected some boards and devices
    Added attenuators and amplifier (not electronic chips! For
    interconnexion drawings).
    Corrected some off gird drawing.
    modified: Lib/symbols/boards/TimXXX.kicad_sym
    modified: Lib/symbols/boards/misc_boards.kicad_sym
    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
2022-08-05 Added TimEX v board
    Added TimEX v1 borad for interconnexion schematics.
    Added gain filled to the amplifier.
    Those are borads and devices not electronics chips.
    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
2022-08-05 Added frequency divider device (not electronic chip!)
    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
2022-08-09 Added solid state relays
    Added DRA-CN024D05, DRA-CN024D24 and DRA1-MPDCD3-B solid state din rail
    relays (not electronic chips!)
    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
2022-09-01 Added optical splitter and LOCAL boards to the misc_boads lib
    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
2022-09-06 Added manufacturer and manufacturer ref to the RF splitter symbol
    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
2022-09-16 Updated some libraries to KiCad 6
2022-09-20 Moving library to Kicad v6
2022-09-22 Moving libraries from Kicad v5 to v6
2022-09-23 Moving libraries to KiCad v6
2022-10-06 added pass band, stop band, low pass and high pass filters
    Connector devices not components !
2022-10-18 Migrating libraries to KiCad v6
2022-10-18 Preparing migration to KiCad v7
2022-10-21 Preparing migration to KiCad v7 ...
2023-02-13 Migration to Kicad v7
    Removed field "Mounted" as this can be replaced by "Do Not Populate" in
    KiCad v7.
2023-02-22 Migration of the library to KiCad v7 Database
    On branch kicad_v7
    new file: Lib/KiCad_Lib.sql
    new file: Lib/Kicad_Lib.kicad_dbl
    new file: Lib/symbols/ZZ_capacitors.kicad_sym
    new file: Lib/symbols/ZZ_resistors.kicad_sym
    modified: scripts/symbols_to_csv/main.go
    modified: scripts/symbols_to_csv/parameters/parameters.go
2023-02-23 Moving to KiCad v7
    modified: Lib/KiCad_Lib.sql
    modified: Lib/Kicad_Lib.kicad_dbl
    modified: Lib/symbols/ADC-DAC/ADC.kicad_sym
    modified: Lib/symbols/ADC-DAC/DAC.kicad_sym
    modified: Lib/symbols/capacitors/capacitors_tantalum.kicad_sym
    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
2023-02-24 Moving to KiCad v7 database
    new file: Lib/symbols/ZZ_ADC_DAC.kicad_sym
    new file: Lib/symbols/ZZ_analogs.kicad_sym
    new file: Lib/symbols/ZZ_connectors.kicad_sym
    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
2023-03-01 Moving to KiCad v7 database
    Changes to be committed:
    modified: Lib/symbols/connectors/HE_connectors.kicad_sym
    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
2023-03-03 Moving libraries to KiCad v7 database
    renamed: Lib/footprints/ZZ_Connector_coaxial.pretty/SMA_Amphenol_132203-12_Horizontal.kicad_mod -> Lib/footprints/ZZ_Connectors_SMA.pretty/SMA_Amphenol_132203-12_Horizontal.kicad_mod
    modified: Lib/symbols/connectors/Lemo_connectors.kicad_sym
    modified: Lib/symbols/connectors/SMA_connectors.kicad_sym
    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
2023-03-09 Moving to KiCad v7 database
    modified: Lib/symbols/ZZ_connectors.kicad_sym
    modified: Lib/symbols/connectors/Terminal_connectors.kicad_sym
    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
2023-03-20 Moving libraries to KiCad v7 database
    new file: Lib/symbols/ZZ_FPGA.kicad_sym
    new file: Lib/symbols/ZZ_diodes.kicad_sym
    new file: Lib/symbols/ZZ_transistors.kicad_sym
    modified: Lib/symbols/discretes/transistors.kicad_sym
    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
2023-03-20 KiCad v7 database
    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
2023-03-21 Decreased the size of attenuators in schematic symbols
2023-03-30 Moving to KiCad V7 database library
2023-03-31 Moving to KiCad V7 database
2023-04-07 Migrated to KiCad v7 database
2023-04-19 Updated ZZ_Diode_SMD:TO-269AA footprint
    Duplicated the Silk layer drawing to the Fab layer, so their no ambiguity between Silk and Fab drawing.
    modified: Lib/footprints/ZZ_Diode_SMD.pretty/TO-269AA.kicad_mod
    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
2023-11-08 Added SFP and SFP cage to the lib
    new file: Lib/footprints/ZZ_Connector_Molex.pretty/Molex_SFP-Host_744410001_2x10_P0.80mm_Horizontal.kicad_mod
    new file: Lib/footprints/ZZ_Connector_TE-Connectivity.pretty/TE-Connectivity_1761014-3_Horizontal.kicad_mod
    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
2023-11-09 Added 3D models to SFP connector and cage
    modified: Lib/footprints/ZZ_Connector_Molex.pretty/Molex_SFP-Host_744410001_2x10_P0.80mm_Horizontal.kicad_mod
    modified: Lib/footprints/ZZ_Connector_TE-Connectivity.pretty/TE-Connectivity_1761014-3_Horizontal.kicad_mod
    new file: Lib/packages3d/ZZ_Connector_Molex.3dshapes/_44410001_cp001.step
    new file: Lib/packages3d/ZZ_Connector_Molex.3dshapes/_44410001_cp001.wrl
    new file: Lib/packages3d/ZZ_Connector_TE-Connectivity.pretty/1761014-3.step
    new file: Lib/packages3d/ZZ_Connector_TE-Connectivity.pretty/1761014-3.wrl
    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
2023-11-09 Corrected not closed courtyard
    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
2023-11-10 Added microSD carte connector. Corrected 3D shapes naming.
    new file: Lib/footprints/ZZ_Connector_Card.pretty/Molex_MicroSD_5025700893_1x8_P0.8mm_Horizontal.kicad_mod
    new file: Lib/packages3d/ZZ_Connector_Card.3dshapes/Molex_MicroSD_5025700893_1x8_P0.8mm_Horizontal.step
    new file: Lib/packages3d/ZZ_Connector_Card.3dshapes/Molex_MicroSD_5025700893_1x8_P0.8mm_Horizontal.wrl
    renamed: Lib/packages3d/ZZ_Connector_Molex.3dshapes/_44410001_cp001.ste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
2023-11-10 Added microSD connector to database
    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
2023-11-13 Added PI4ULS3V4857GEAEX
    renamed: Lib/footprints/ZZ_RJ45_connectors.pretty/SOLEIL-RJ45-HFJ11-1G01E-L12RL.kicad_mod -> Lib/footprints/ZZ_Connectors_RJ45.pretty/SOLEIL-RJ45-HFJ11-1G01E-L12RL.kicad_mod
    new file: Lib/footprints/ZZ_Package_CSP.pretty/WLCSP-20_1.934x2.434mm_Layout4x5_P0.4mm.kicad_mod
    modified: Lib/symbols/ZZ_interfaces.kicad_sym
    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
2023-11-14 Added RJ45_L829-1J1T-43 symbol and footprint
    modified: Lib/footprints/ZZ_Connector_Phoenix.pretty/PhoenixContact_MPT_1725669_1x03mm_P2.54mm_Vertical.kicad_mod
    new file: Lib/footprints/ZZ_Connector_RJ.pretty/RJ45_BEL_L829-1J1T-43_Horizontal.kicad_mod
    renamed: Lib/footprints/ZZ_Connectors_RJ45.pretty/SOLEIL-RJ45-HFJ11-1G01E-L12RL.kicad_mod -> Lib/footprints/ZZ_Connector_RJ.pretty/SOLEIL-RJ45-HFJ11-1G01E-L12RL.kicad_mod
    new file: Lib/packages3d/ZZ_Connector_RJ.3dshapes/RJ45_BEL_L829-1J1T-43_Horizontal.step
    new file: Lib/packages3d/ZZ_Connector_RJ.3d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
2023-11-14 Updated database with L829-1J1T-43
    modified: Lib/footprints/ZZ_Connector_RJ.pretty/RJ45_BEL_L829-1J1T-43_Horizontal.kicad_mod
    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
2023-11-17 Added 3D models to footprints
    modified: Lib/footprints/ZZ_Package_CSP.pretty/WLCSP-20_1.934x2.434mm_Layout4x5_P0.4mm.kicad_mod
    new file: Lib/footprints/ZZ_Package_DFN_QFN.pretty/VQFN-48-1EP_7x7mm_P0.5mm_EP4.1x4.1mm_ThermalVias.kicad_mod
    new file: Lib/packages3d/ZZ_Package_CSP.3dshapes/WLCSP-20_1.7x2.1mm_Layout4x5_P0.4mm.step
    new file: Lib/packages3d/ZZ_Package_CSP.3dshapes/WLCSP-20_1.7x2.1mm_Layout4x5_P0.4mm.wrl
    renamed: Lib/packages3d/Package_DFN_QFN.3dshapes/DFN-8_2x2mm_P0.5mm.step -> Lib/packages3d/ZZ_Package_DFN_QFN.3dshapes/DFN-8_2x2mm_P0.5mm.step
    renamed: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
2023-11-17 Adjuted some footprint and 3D models to KLC
    new file: Lib/footprints/ZZ_Package_CSP.pretty/DIODES-INC_WLCSP-20_1.70x2.10mm_Layout4x5_P0.4mm.kicad_mod
    renamed: Lib/packages3d/ZZ_Package_CSP.3dshapes/WLCSP-20_1.7x2.1mm_Layout4x5_P0.4mm.step -> Lib/packages3d/ZZ_Package_CSP.3dshapes/DIODES-INC_WLCSP-20_1.7x2.1mm_Layout4x5_P0.4mm.step
    renamed: Lib/packages3d/ZZ_Package_CSP.3dshapes/WLCSP-20_1.7x2.1mm_Layout4x5_P0.4mm.wrl -> Lib/packages3d/ZZ_Package_CSP.3dshapes/DIODES-INC_WLCSP-20_1.7x2.1mm_Layout4x5_P0.4mm.wrl
    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
2023-11-20 Corrected 87832-1420 and DP83867CRRGZR symbols
    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
2023-11-21 Added JTAG connector Molex 878321420
    Correted alignement to be conforme with KLC
    new file: Lib/footprints/ZZ_Connector_Molex.pretty/Molex_Milli-Gird_878321420_2x07_P2.00mm_Vertical_SMD.kicad_mod
    modified: Lib/footprints/ZZ_Connector_PinHeader.pretty/PinHeader-2x07_P2mm_Vertical_SMD.kicad_mod
    new file: Lib/packages3d/ZZ_Connector_Molex.3dshapes/Molex_Milli-Gird_878321420_2x07_P2.00mm_Vertical_SMD.step
    new file: Lib/packages3d/ZZ_Connector_Molex.3dshapes/Molex_Milli-Gird_878321420_2x07_P2.00mm_Vertical_SMD.wrl
    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
2023-11-21 Created some components
    modified: Lib/footprints/ZZ_Package_SO.pretty/SOIC-8_3.9x4.9mm_P1.27mm.kicad_mod
    new file: Lib/footprints/ZZ_Package_TO_SOT_SMD.pretty/SOT-363_SC-70-6.kicad_mod
    new file: Lib/packages3d/ZZ_Package_TO_SOT_SMD.3dshapes/SOT-363_SC-70-6.step
    new file: Lib/packages3d/ZZ_Package_TO_SOT_SMD.3dshapes/SOT-363_SC-70-6.wrl
    modified: Lib/symbols/ZZ_logic.kicad_sym
    new file: Lib/symbols/ZZ_memory.kicad_sym
    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
2023-11-22 Added micro USB B 473460001
    Added component for micro USB B 47346-0001
    Reformated SMA folder to KLC
    renamed: Lib/footprints/ZZ_Connectors_SMA.pretty/SMA_Amphenol_132203-12_Horizontal.kicad_mod -> Lib/footprints/ZZ_Connector_SMA.pretty/SMA_Amphenol_132203-12_Horizontal.kicad_mod
    renamed: Lib/footprints/ZZ_Connectors_SMA.pretty/SOLEIL-SMA-132134.kicad_mod -> Lib/footprints/ZZ_Connector_SMA.pretty/SOLEIL-SMA-132134.kicad_mod
    renamed: Lib/footprints/ZZ_Connectors_SMA.pretty/SOLEIL-SMA-132430.kicad_mod -> Lib/footprints/ZZ_Connector_SMA.pretty/SOLEIL-SMA-132430.kicad_mod
    renamed: Lib/footprints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
2023-11-23 Added TVS TPD4S012DRYR
    new file: Lib/footprints/ZZ_Package_SON/Texas_USON-6_1x1.45mm_P0.5mm_SMD.kicad_mod
    new file: Lib/packages3d/ZZ_Package_SON.3dshapes/USON-6_1x1.45mm_P0.5mm.step
    new file: Lib/packages3d/ZZ_Package_SON.3dshapes/USON-6_1x1.45mm_P0.5mm.wrl
    renamed: Lib/symbols/ZZ_PSU.kicad_sym -> Lib/symbols/ZZ_Power.kicad_sym
    new file: Lib/symbols/ZZ_Power_Protection.kicad_sym
    modified: Lib/symbols/ZZ_memory.kicad_sym
    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
2023-11-23 Added FT4232HL
    new file: Lib/footprints/ZZ_Package_DFN_QFN.pretty/LQFP-64_10x10mm_P0.5mm.kicad_mod
    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
2023-11-23 Added ABM8G-12.000MHZ-8-B2X-T
    new file: Lib/footprints/ZZ_Oscillator.pretty/Crystal_SMD_3225-4Pin_3.2x2.5mm.kicad_mod
    modified: Lib/symbols/ZZ_oscillators.kicad_sym
    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
2023-11-23 Added DP83867CRRGZR to database
    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
2023-11-24 Added SN74HCS09PWR + clean-up
    modified: Lib/footprints/ZZ_Connector_Card.pretty/Molex_MicroSD_5025700893_1x8_P0.8mm_Horizontal.kicad_mod
    modified: Lib/footprints/ZZ_Connector_Molex.pretty/Molex_Milli-Gird_878321420_2x07_P2.00mm_Vertical_SMD.kicad_mod
    modified: Lib/footprints/ZZ_Connector_USB.pretty/USB_Micro-B_Molex_47346-0001.kicad_mod
    modified: Li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
2023-11-24 Added LTC2919CMS-2.5 and LTC2919CMS-3.5
    deleted: Lib/footprints/CPCI.brd
    new file: Lib/footprints/ZZ_Package_SO.pretty/MSOP-10_3x3mm_P0.5mm.kicad_mod
    deleted: Lib/footprints/ZZ_SO.pretty/SOLEIL-HV1195.kicad_mod
    deleted: Lib/footprints/ZZ_SO.pretty/SOLEIL-SOIC8NB.kicad_mod
    new file: Lib/packages3d/ZZ_Package_SO.3dshapes/MSOP-10_3x3mm_P0.5mm.step
    new file: Lib/packages3d/ZZ_Package_SO.3dshapes/MSOP-10_3x3mm_P0.5mm.wrl
    modified: Lib/symbols/ZZ_voltage_monitor.kicad_sym
    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
2023-11-24 Added TLV840MADL30DBVR
    modified: Lib/footprints/ZZ_Package_TO_SOT_SMD.pretty/SOT-23-5.kicad_mod
    new file: Lib/packages3d/ZZ_Package_TO_SOT_SMD.3dshapes/SOT-23-5.step
    new file: Lib/packages3d/ZZ_Package_TO_SOT_SMD.3dshapes/SOT-23-5.wrl
    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
2023-11-24 Updated database
    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
2023-11-27 Added SN74AVC2T245RSWR
    modified: Lib/footprints/ZZ_Package_CSP.pretty/DIODES-INC_WLCSP-20_1.70x2.10mm_Layout4x5_P0.4mm.kicad_mod
    new file: Lib/footprints/ZZ_Package_DFN_QFN.pretty/Texas_UQFN-10_1.4x1.8mm_P0.4mm.kicad_mod
    new file: Lib/packages3d/ZZ_Package_DFN_QFN.3dshapes/UQFN-10_1.4x1.8mm_P0.4mm.step
    new file: Lib/packages3d/ZZ_Package_DFN_QFN.3dshapes/UQFN-10_1.4x1.8mm_P0.4mm.wrl
    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
2023-11-27 Added PCA9306DCTR
    modified: Lib/footprints/ZZ_Package_SO.pretty/MSOP-8_3x3mm_P0.65mm.kicad_mod
    modified: Lib/footprints/ZZ_Package_SO.pretty/SOIC-14_3.9x8.7mm_P1.27mm.kicad_mod
    modified: Lib/footprints/ZZ_Package_SO.pretty/SOIC-20W_7.5x12.8mm_P1.27mm.kicad_mod
    new file: Lib/footprints/ZZ_Package_SO.pretty/SSOP-8_2.95x2.8mm_P0.65mm.kicad_mod
    modified: Lib/footprints/ZZ_Package_SO.pretty/TSSOP-14_4.4x5mm_P0.65mm.kicad_mod
    modified: Lib/footprints/ZZ_Package_SO.pretty/TSSOP-20_4.4x6.5mm_P0.65mm.kicad_mod
    modified: Lib/footprints/ZZ_Package_SO.pretty/TSSOP-38_4.4x9.7mm_P0.5mm.kicad_mod
    new file: Lib/packages3d/ZZ_Package_S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
2023-11-27 Added M24C64-DRDW8
    new file: Lib/footprints/ZZ_Package_SO.pretty/TSSOP-8_4.4x3mm_P0.65mm.kicad_mod
    new file: Lib/packages3d/ZZ_Package_SO.3dshapes/TSSOP-8_4.4x3mm_P0.65mm.step
    new file: Lib/packages3d/ZZ_Package_SO.3dshapes/TSSOP-8_4.4x3mm_P0.65mm.wrl
    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
2023-11-27 Added TPS3430WDRCR
    modified: Lib/footprints/ZZ_Package_SON/Texas_USON-6_1x1.45mm_P0.5mm_SMD.kicad_mod
    new file: Lib/footprints/ZZ_Package_SON/VSON-10-1EP_3x3mm_P0.5mm_EP1.65x2.4mm_ThermalVias.kicad_mod
    new file: Lib/packages3d/ZZ_Package_SON.3dshapes/VSON-10-1EP_3x3mm_P0.5mm_EP1.65x2.4mm.step
    new file: Lib/packages3d/ZZ_Package_SON.3dshapes/VSON-10-1EP_3x3mm_P0.5mm_EP1.65x2.4mm.wrl
    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
2023-11-28 Added Kria K26 som240_1 and som240_2 connectors symbols.
    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
2023-11-28 Corrected pin type error in Kria SOM K26 connectors.
    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
2023-11-29 Corrected mistakes in Kria connector
2023-11-30 Added SAMTEC_ADM6-60-01.5-L-4-2-A-TR_4x60_P0.635mm_Vertical_SMD footprint
    new file: Lib/footprints/ZZ_Connector_Samtec.pretty/SAMTEC_ADM6-60-01.5-L-4-2-A-TR_4x60_P0.635mm_Vertical_SMD.kicad_mod
    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
2023-11-30 Added Kria SOM K26 connectors to database
    modified: Lib/footprints/ZZ_Connector_Samtec.pretty/SAMTEC_ADM6-60-01.5-L-4-2-A-TR_4x60_P0.635mm_Vertical_SMD.kicad_mod
    new file: Lib/packages3d/ZZ_Connector_Samtec.3dshapes/SAMTEC_ADM6-60-01.5-L-4-2-A-TR_4x60_P0.635mm_Vertical_SMD.step
    new file: Lib/packages3d/ZZ_Connector_Samtec.3dshapes/SAMTEC_ADM6-60-01.5-L-4-2-A-TR_4x60_P0.635mm_Vertical_SMD.wrl
    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
2023-11-30 Added DMN26D0UT-7
    new file: Lib/footprints/ZZ_Package_TO_SOT_SMD.pretty/SOT-523.kicad_mod
    new file: Lib/packages3d/ZZ_Package_TO_SOT_SMD.3dshapes/SOT-523.step
    new file: Lib/packages3d/ZZ_Package_TO_SOT_SMD.3dshapes/SOT-523.wrl
    modified: Lib/symbols/ZZ_Power.kicad_sym
    new file: Lib/symbols/ZZ_discrets.kicad_sym
    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
2023-12-01 Added MP8904DD–LF–Z
    new file: Lib/footprints/ZZ_Package_DFN_QFN.pretty/QFN-8-1EP_3x2mm_P0.5mm_EP1.6x1.7mm.kicad_mod
    new file: Lib/packages3d/ZZ_Package_DFN_QFN.3dshapes/QFN-08-1EP_2x3mm_P0.5mm_EP1.6x1.7mm.step
    new file: Lib/packages3d/ZZ_Package_DFN_QFN.3dshapes/QFN-08-1EP_2x3mm_P0.5mm_EP1.6x1.7mm.wrl
    modified: Lib/symbols/ZZ_discrets.kicad_sym
    modified: Lib/symbols/ZZ_transistors.kicad_sym
    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
2023-12-04 Added MPM3810A
    new file: Lib/footprints/ZZ_Package_DFN_QFN.pretty/MPS_MPM3810_QFN-12_2.5x3mm.kicad_mod
    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
2023-12-05 Added MPM3840GQV-Z
    renamed: Lib/footprints/ZZ_Package_DFN_QFN.pretty/MPS_MPM3810_QFN-12_2.5x3mm.kicad_mod -> Lib/footprints/ZZ_Package_DFN_QFN.pretty/MPS_MPM3810_QFN-12_2.5x3mm_P0.4mm.kicad_mod
    new file: Lib/footprints/ZZ_Package_DFN_QFN.pretty/MPS_MPM3840_QFN-20_3x5mm_P0.5mm.kicad_mod
    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
2023-12-06 Added MP8772
    On branch back_to_v7
    new file: Lib/footprints/ZZ_Package_DFN_QFN.pretty/MPS_MP8772_QFN-20_3x3mm_P0.4mm.kicad_mod
    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
2023-12-07 Added INA 260
    new file: Lib/footprints/ZZ_Package_SO.pretty/TSSOP-16_4.4x5mm_P0.65mm.kicad_mod
    new file: Lib/packages3d/ZZ_Package_SO.3dshapes/TSSOP-16_4.4x5mm_P0.65mm.step
    new file: Lib/packages3d/ZZ_Package_SO.3dshapes/TSSOP-16_4.4x5mm_P0.65mm.wrl
    new file: Lib/symbols/ZZ_sensor.kicad_sym
    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
2023-12-07 Changed some footprint to make them compatible with KiCad V7.99
    modified: Lib/footprints/ZZ_Package_DFN_QFN.pretty/MPS_MPM3810_QFN-12_2.5x3mm_P0.4mm.kicad_mod
    new file: Lib/footprints/ZZ_Package_DFN_QFN.pretty/MPS_MPM3810_QFN-12_2.5x3mm_P0.4mm_1.kicad_mod
    modified: Lib/footprints/ZZ_Package_DFN_QFN.pretty/MPS_MPM3840_QFN-20_3x5mm_P0.5mm.kicad_mod
    new file: Lib/footprints/ZZ_Package_DFN_QFN.pretty/MPS_MPM3840_QFN-20_3x5mm_P0.5mm_1.kicad_mod
    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
2023-12-07 Adjusted some component to KLC
    modified: Lib/footprints/ZZ_Connector_Phoenix.pretty/PhoenixContact_MKDS_1x02_P5mm_Vertical.kicad_mod
    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
2023-12-11 Reorganized lib + some addition
    new file: Lib/footprints/ZZ_Capacitor_SMD.pretty/CP_Elec_5x5.8.kicad_mod
    new file: Lib/footprints/ZZ_Capacitor_SMD.pretty/CP_Elec_6.3x5.3.kicad_mod
    new file: Lib/footprints/ZZ_Capacitor_SMD.pretty/CP_Elec_6.3x5.8.kicad_mod
    new file: Lib/footprints/ZZ_Capacitor_SMD.pretty/CP_Elec_8x10.kicad_mod
    deleted: Lib/footprints/ZZ_Filter.pretty/Filter_Murata-NFM41P.kicad_mod
    new file: Lib/footprints/ZZ_Filter.pretty/Murata_NFM41P.kicad_mod
    new file: Lib/footprints/ZZ_Inductor_SMD/L_0603_1608Metric.kicad_mod
    new file: Lib/footprints/ZZ_Inductor_SMD/L_Bourns_SRP5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
2023-12-11 Changed inductors value visibility to false
    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
2023-12-12 Added diode, resistors, capacitors and inductances
    new file: Lib/footprints/ZZ_Diode_SMD.pretty/D_SOD-123.kicad_mod
    modified: Lib/footprints/ZZ_Package_TO_SOT_SMD.pretty/SOT-23-3.kicad_mod
    new file: Lib/packages3d/ZZ_Diode_SMD.3dshapes/D_SOD-123.step
    new file: Lib/packages3d/ZZ_Diode_SMD.3dshapes/D_SOD-123.wrl
    new file: Lib/packages3d/ZZ_Package_TO_SOT_SMD.3dshapes/SOT-23-3.step
    new file: Lib/packages3d/ZZ_Package_TO_SOT_SMD.3dshapes/SOT-23-3.wrl
    modified: Lib/symbols/ZZ_capacitors.kicad_sym
    modified: Lib/symbols/ZZ_diodes.kicad_sym
    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
2023-12-13 Added resistors and capacitors
    modified: Lib/symbols/ZZ_Power_Supply.kicad_sym
    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
2024-01-08 Various corrections aand additions
    new file: Lib/footprints/ZZ_Connector_Samtec.pretty/Samtec_TSM-103-SV_1x03_P2.54mm_Vertical_SMD.kicad_mod
    new file: Lib/packages3d/ZZ_Connector_Samtec.3dshapes/Samtec_TSM-103-SV_1x03_P2.54mm_Vertical_SMD.step
    new file: Lib/packages3d/ZZ_Connector_Samtec.3dshapes/Samtec_TSM-103-SV_1x03_P2.54mm_Vertical_SMD.wrl
    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
2024-01-09 Added 25MHz osc ; corrected eternet interface symbole
    new file: Lib/footprints/ZZ_Oscillator.pretty/Oscillator_SMD_ECS-2016MV_2.0x1.6mm.kicad_mod
    new file: Lib/packages3d/ZZ_Oscillator/Oscillator_SMD_ECS-2016MV_2.0x1.6mm.step
    new file: Lib/packages3d/ZZ_Oscillator/Oscillator_SMD_ECS-2016MV_2.0x1.6mm.wrl
    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
2024-01-11 Added some components ; re-arranged SD card connector
    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
2024-01-11 Added IHLP2020BZER4R7M11 inductor
    new file: Lib/footprints/ZZ_Inductor_SMD/L_Vishay_IHLP-2020.kicad_mod
    new file: Lib/packages3d/ZZ_Inductor_SMD/L_Vishay_IHLP-2020.step
    new file: Lib/packages3d/ZZ_Inductor_SMD/L_Vishay_IHLP-2020.wrl
    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
2024-01-12 Added FDN336P transistor
    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
2024-01-12 Corrected SFP+ cage miss alignement
    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
2024-01-16 Added SFP+ oscillators + resistors
    modified: Lib/footprints/ZZ_Oscillator.pretty/Oscillator_SMD_SI510_4Pin_7x5mm.kicad_mod
    modified: Lib/symbols/ZZ_switch.kicad_sym
    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
2024-01-18 Added some resitors
    new file: Lib/footprints/ZZ_Inductor_SMD/L_0805_2012Metric_Pad1.15x1.40mm_HandSolder.kicad_mod
    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
2024-01-19 Added SN74AVC4T245RSVR
    new file: Lib/footprints/ZZ_Package_DFN_QFN.pretty/Texas_UQFN-16_1.8x2.6mm_P0.4mm.kicad_mod
    new file: Lib/packages3d/ZZ_Package_DFN_QFN.3dshapes/Texas_UQFN-16_1.8x2.6mm_P0.4mm.step
    new file: Lib/packages3d/ZZ_Package_DFN_QFN.3dshapes/Texas_UQFN-16_1.8x2.6mm_P0.4mm.wrl
    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
2024-01-23 Added NB4L52MNG
    new file: Lib/footprints/ZZ_Package_DFN_QFN.pretty/QFN-16-1EP_3x3mm_P0.5mm_EP1.9x1.9mm.kicad_mod
    new file: Lib/packages3d/ZZ_Package_DFN_QFN.3dshapes/QFN-16-1EP_3x3mm_P0.5mm_EP1.9x1.9mm.step
    new file: Lib/packages3d/ZZ_Package_DFN_QFN.3dshapes/QFN-16-1EP_3x3mm_P0.5mm_EP1.9x1.9mm.wrl
    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
2024-01-23 Added again NC7WZ07P6X which was delated by mistake
    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
2024-01-29 Added MC100EPT21 and LT30140
    new file: Lib/footprints/ZZ_Package_DFN_QFN.pretty/DFN-10-1EP_3x3mm_P0.5mm_EP1.65x2.38mm.kicad_mod
    new file: Lib/packages3d/ZZ_Package_DFN_QFN.3dshapes/DFN-10-1EP_3x3mm_P0.5mm_EP1.65x2.38mm.step
    new file: Lib/packages3d/ZZ_Package_DFN_QFN.3dshapes/DFN-10-1EP_3x3mm_P0.5mm_EP1.65x2.38mm.wrl
    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
2024-01-30 Added some resistors
2024-02-02 Added serial led, and push button switch
    new file: Lib/footprints/ZZ_LED_SMD.pretty/LED_WS2812B_PLCC4_5.0x5.0mm_P3.2mm.kicad_mod
    new file: Lib/footprints/ZZ_Passives.pretty/SW_Push_1P1T_NO_CK_KMR2.kicad_mod
    new file: Lib/packages3d/ZZ_LED_SMD.3dshapes/LED_WS2812B_PLCC4_5.0x5.0mm_P3.2mm.step
    new file: Lib/packages3d/ZZ_LED_SMD.3dshapes/LED_WS2812B_PLCC4_5.0x5.0mm_P3.2mm.wrl
    modified: Lib/symbols/ZZ_LED.kicad_sym
    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
2024-02-06 Updated Laird's RF shield
    deleted: Lib/footprints/ZZ_RF_shield.pretty/BMI-S-204-F.kicad_mod
    new file: Lib/footprints/ZZ_RF_shield.pretty/Laird_BMI-S-204-F_32x32x6mm.kicad_mod
    new file: Lib/packages3d/ZZ_Shields.3dshapes/Laird_BMI-S-204-F_32x32x6mm.step
    new file: Lib/packages3d/ZZ_Shields.3dshapes/Laird_BMI-S-204-F_32x32x6mm.wrl
    modified: Lib/symbols/ZZ_shields.kicad_sym
    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
2024-02-07 Added some mounting holes
    new file: Lib/footprints/ZZ_MountingHole.pretty/MountingHole_3.2mm_M3_Pad.kicad_mod
    new file: Lib/footprints/ZZ_MountingHole.pretty/MountingHole_4.5mm_Pad.kicad_mod
    modified: Lib/symbols/ZZ_mounting_holes.kicad_sym
    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
2024-02-08 Adjusted line witdh to 10 on some symbols
    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
2024-02-12 Added HMC705, RF shield, etc.
    new file: Lib/footprints/ZZ_Package_DFN_QFN.pretty/QFN-24-1EP_4x4mm_P0.5mm_EP2.8x2.8mm_ThermalVias.kicad_mod
    new file: Lib/packages3d/ZZ_Package_DFN_QFN.3dshapes/QFN-24-1EP_4x4mm_P0.5mm_EP2.8x2.8mm_ThermalVias.step
    new file: Lib/packages3d/ZZ_Package_DFN_QFN.3dshapes/QFN-24-1EP_4x4mm_P0.5mm_EP2.8x2.8mm_ThermalVias.wrl
    modified: Lib/symbols/ZZ_RF.kicad_sym
    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
2024-02-13 Added HMC705
    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
2024-02-14 Added some Mini-Circuits components
    new file: Lib/footprints/ZZ_Package_DFN_QFN.pretty/Mini-Circuits_FG873-4_3x3mm.kicad_mod
    new file: Lib/footprints/ZZ_Package_DFN_QFN.pretty/QFN-12-1EP_3x3mm_P0.51mm_EP1.45x1.45mm.kicad_mod
    deleted: Lib/footprints/ZZ_Package_QFP.pretty/DQ1225-12_3x3mm_P0.5mm.kicad_mod
    modified: Lib/footprints/ZZ_RF_Mini-Circuits.pretty/Mini-Circuits_MC1631.kicad_mod
    modified: Lib/packages3d/ZZ_Package_DFN_QFN.3dshapes/Mini-Circuits_FG873-4_3x3mm.step
    modified: Lib/packages3d/ZZ_Package_DFN_QFN.3dshapes/Mini-Circuits_FG873-4_3x3mm.wrl
    new file: Lib/packages3d/ZZ_Package_DFN_QFN.3dshapes/QFN-12-1EP_3x3mm_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
2024-02-15 Some redrawing of components
    modified: Lib/footprints/ZZ_Package_QFP.pretty/LQFP-48_7x7mm_P0.5mm.kicad_mod
    modified: Lib/symbols/ZZ_ADC_DAC.kicad_sym
    modified: Lib/symbols/ZZ_analogs.kicad_sym
    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
2024-02-19 Added Texas Instruments SN74LV1T125
    new file: Lib/footprints/ZZ_Package_TO_SOT_SMD.pretty/Texas_SC70_DCK-5.kicad_mod
    new file: Lib/packages3d/ZZ_Package_TO_SOT_SMD.3dshapes/Texas_SC70_DCK-5.step
    new file: Lib/packages3d/ZZ_Package_TO_SOT_SMD.3dshapes/Texas_SC70_DCK-5.wrl
    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
2024-02-21 Added Laird BMI-S-226-F + reshaped some symbols
    modified: Lib/footprints/ZZ_RF_shield.pretty/Laird_BMI-S-204-F_32x32x6mm.kicad_mod
    new file: Lib/footprints/ZZ_RF_shield.pretty/Laird_BMI-S-226-F_34.93x71.12x10.16mm.kicad_mod
    new file: Lib/packages3d/ZZ_Shields.3dshapes/Laird_BMI-S-226-F_34.93x71.12x10.16mm.step
    new file: Lib/packages3d/ZZ_Shields.3dshapes/Laird_BMI-S-226-F_34.93x71.12x10.16mm.wrl
    modified: Lib/symbols/ZZ_voltage_reference.kicad_sym
    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
2024-02-21 Added ADL5375
    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
2024-02-22 Added DS1620 + cleaned up some footprints
2024-02-26 added MC100EPT20 ; corrected ref of MC100EPT21
    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
2024-02-28 Changed some symbols to avoid DRC messages
    modified: Lib/symbols/ZZ_sensor.kicad_sym
    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
2024-02-29 Changed some symbols to avoid DRC in KiCad
    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
2024-03-05 Added 887R
    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
2024-03-06 Added 237R
    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
2024-03-12 Minor correction to some footprints
    modified: Lib/footprints/ZZ_LED_SMD.pretty/LED_1206_3216Metric.kicad_mod
    deleted: Lib/footprints/ZZ_Package_DFN_QFN.pretty/MPS_MPM3810_QFN-12_2.5x3mm_P0.4mm_1.kicad_mod
    deleted: Lib/footprints/ZZ_Package_DFN_QFN.pretty/MPS_MPM3840_QFN-20_3x5mm_P0.5mm_1.kicad_mod
    modified: Lib/footprints/ZZ_Package_DFN_QFN.pretty/Texas_S-PVQFN-N36_EP4.6x4.6mm.kicad_mod
    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
2024-04-08 Corrected some error between footprint thermal pad and symbols
    modified: Lib/footprints/ZZ_Package_DFN_QFN.pretty/Texas_S-PVQFN-N20_EP3.15x3.15mm_ThermalVias.kicad_mod
    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
2024-04-09 Updated SMD LED symbol and footprint to Anode pin2, Cathod pin 2
    modified: Lib/footprints/ZZ_LED_SMD.pretty/LED_0805_2012Metric.kicad_mod
    new file: Lib/footprints/ZZ_LED_SMD.pretty/LED_0805_2012Metric_R.kicad_mod
    new file: Lib/footprints/ZZ_LED_SMD.pretty/LED_1206_3216Metric_R.kicad_mod
    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
2024-04-22 Swaped FOUT and NFOUT to simplify schematics on HMC705 symbol
    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
2024-04-30 Corrected SFP+ connector 3D orientation
    modified: Lib/packages3d/ZZ_Connector_Molex.3dshapes/Molex_SFP-Host_744410001_2x10_P0.80mm_Horizontal.step
    modified: Lib/packages3d/ZZ_Connector_Molex.3dshapes/Molex_SFP-Host_744410001_2x10_P0.80mm_Horizontal.wrl
    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
2024-04-30 Added 3D model for Bivar SMFLP
    modified: Lib/footprints/ZZ_OptoDevice.pretty/Bivar_SMFLP.kicad_mod
    new file: Lib/packages3d/ZZ_OptoDevice.3dshapes/Bivar_SMFLP.step
    new file: Lib/packages3d/ZZ_OptoDevice.3dshapes/Bivar_SMFLP.wrl
    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
2024-06-26 iAdded symbols lib, WS2812 pipe, monting holeiAdded symbols lib, WS2812 pipe, monting hole
2024-07-01 Added TDK YFF31HC 3 pins capacitor
    new file: Lib/footprints/ZZ_Filter.pretty/TDK_YFF31HC.kicad_mod
    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
2024-07-11 Added PRL450 (a device not a component)
    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
2024-08-26 Cleaned some footprints
    modified: Lib/footprints/ZZ_Capacitor_Tantalum_SMD.pretty/CP_EIA-3216-18_Kemet-A.kicad_mod
    modified: Lib/footprints/ZZ_Package_DFN_QFN.pretty/MPS_MP8772_QFN-20_3x3mm_P0.4mm.kicad_mod
    modified: Lib/footprints/ZZ_Passives.pretty/TEST-22.kicad_mod
    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
2024-08-27 Corrected LED silkscreen to avoid overlap with LED pipeCorrected LED
    modified: Lib/footprints/ZZ_LED_SMD.pretty/LED_1206_3216Metric_R.kicad_mod
    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
2024-08-27 Corrected MPxx footprints
    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
2024-09-03 Corrected MPM3810 footprint courtyard error
    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
2024-09-10 Added TXS02612RTWR to the lib
    Created library "logic_levelTranslator".
    Added TXS02612RTWR, moved PI4ULS3V4857 to this lib
    new file: Lib/footprints/ZZ_Package_DFN_QFN.pretty/WQFN-24-1EP_4x4mm_P0.5mm_EP2.45x2.45mm_ThermalVias.kicad_mod
    new file: Lib/symbols/ZZ_logic_levelTranslator.kicad_sym
    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
2024-09-11 Added TXS02612RTWR SD card level translator
    modified: Lib/footprints/ZZ_Package_DFN_QFN.pretty/WQFN-24-1EP_4x4mm_P0.5mm_EP2.45x2.45mm_ThermalVias.kicad_mod
    new file: Lib/packages3d/ZZ_Package_DFN_QFN.3dshapes/Texas_RTW_WQFN-24-1EP_4x4mm_P0.5mm_EP2.45x2.45mm.step
    new file: Lib/packages3d/ZZ_Package_DFN_QFN.3dshapes/Texas_RTW_WQFN-24-1EP_4x4mm_P0.5mm_EP2.45x2.45mm.wrl
    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
2026-01-08 Added Highland Technology T560 and T660 modules (not PCB footprinti!)
    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
